hkxs/expansion-delfino/hardware/Delfino_Audio_Cape/Docs/Tarjeta/3D_Front.jpg

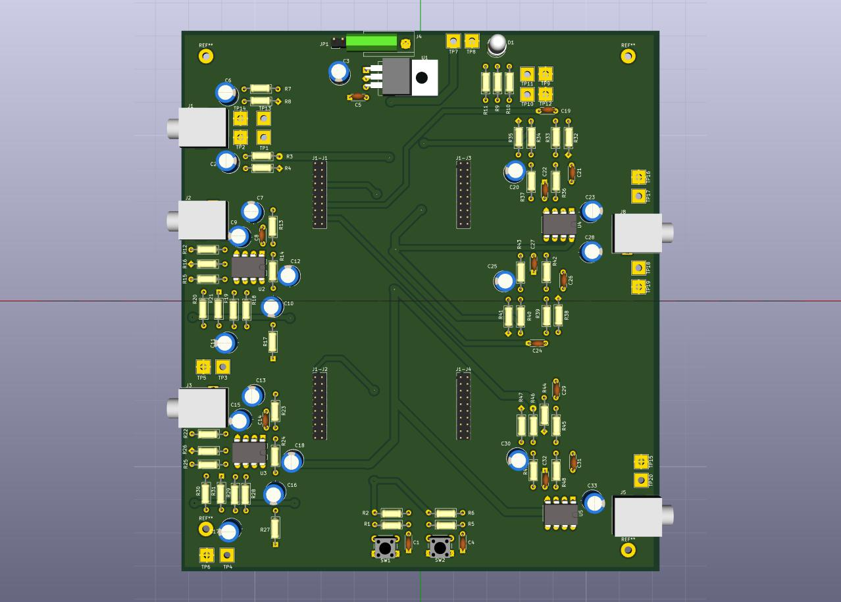
hardware/Delfino_Audio_Cape/Docs/Tarjeta/3D_Front.jpg
