hkxs/expansion-delfino/hardware/Delfino_Audio_Cape/Docs/Tarjeta/3D_Back.jpg

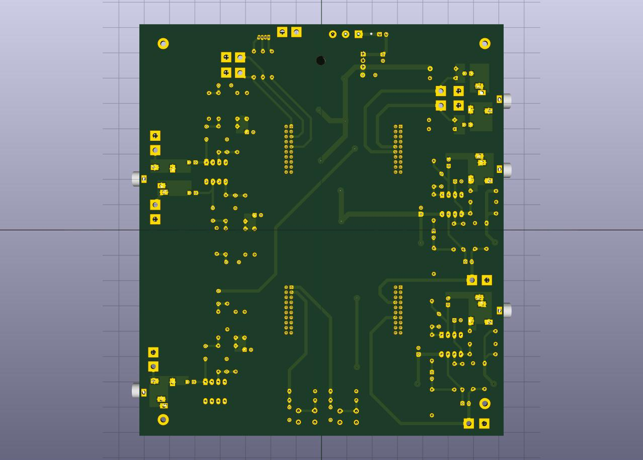
hardware/Delfino_Audio_Cape/Docs/Tarjeta/3D_Back.jpg
