hkxs/expansion-delfino/README.md

# expansion-delfino
Tarjeta de expansión para el launchpad LAUNCHXL-F28377S

Para un tutorial rápido sobre el MCU TMS320F28377S se puede consultar:

http://odin.fi-b.unam.mx/labdsp/files/ADSP/apuntes/Tutorial_VF.pdf
