hkxs/expansion-delfino/hardware/NOTES.md

Todos los proyectos están creados en KiCad.

En caso de fabricación casera, se recomienda usar vías de 100 mil y pistas de al menos 35 mil.
