hkxs/expansion-delfino/hardware/Delfino_Audio_Cape/Docs/Simulacion/LP_Filter/respuesta_freq.bmp

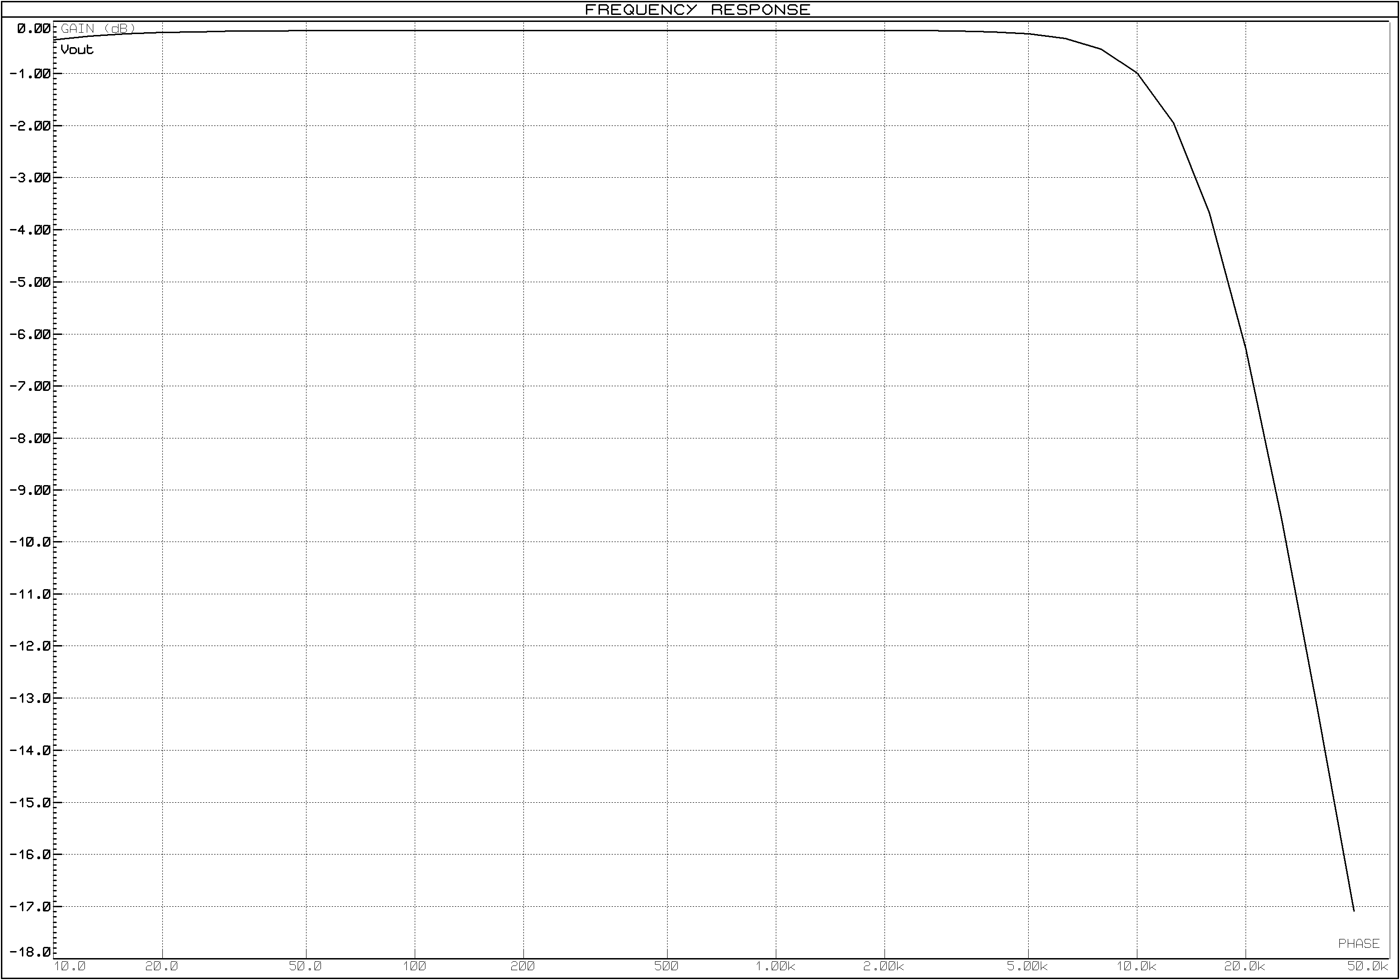
hardware/Delfino_Audio_Cape/Docs/Simulacion/LP_Filter/respuesta_freq.bmp
