hkxs/expansion-delfino/hardware/Amp_Mic/esquematico.pdf

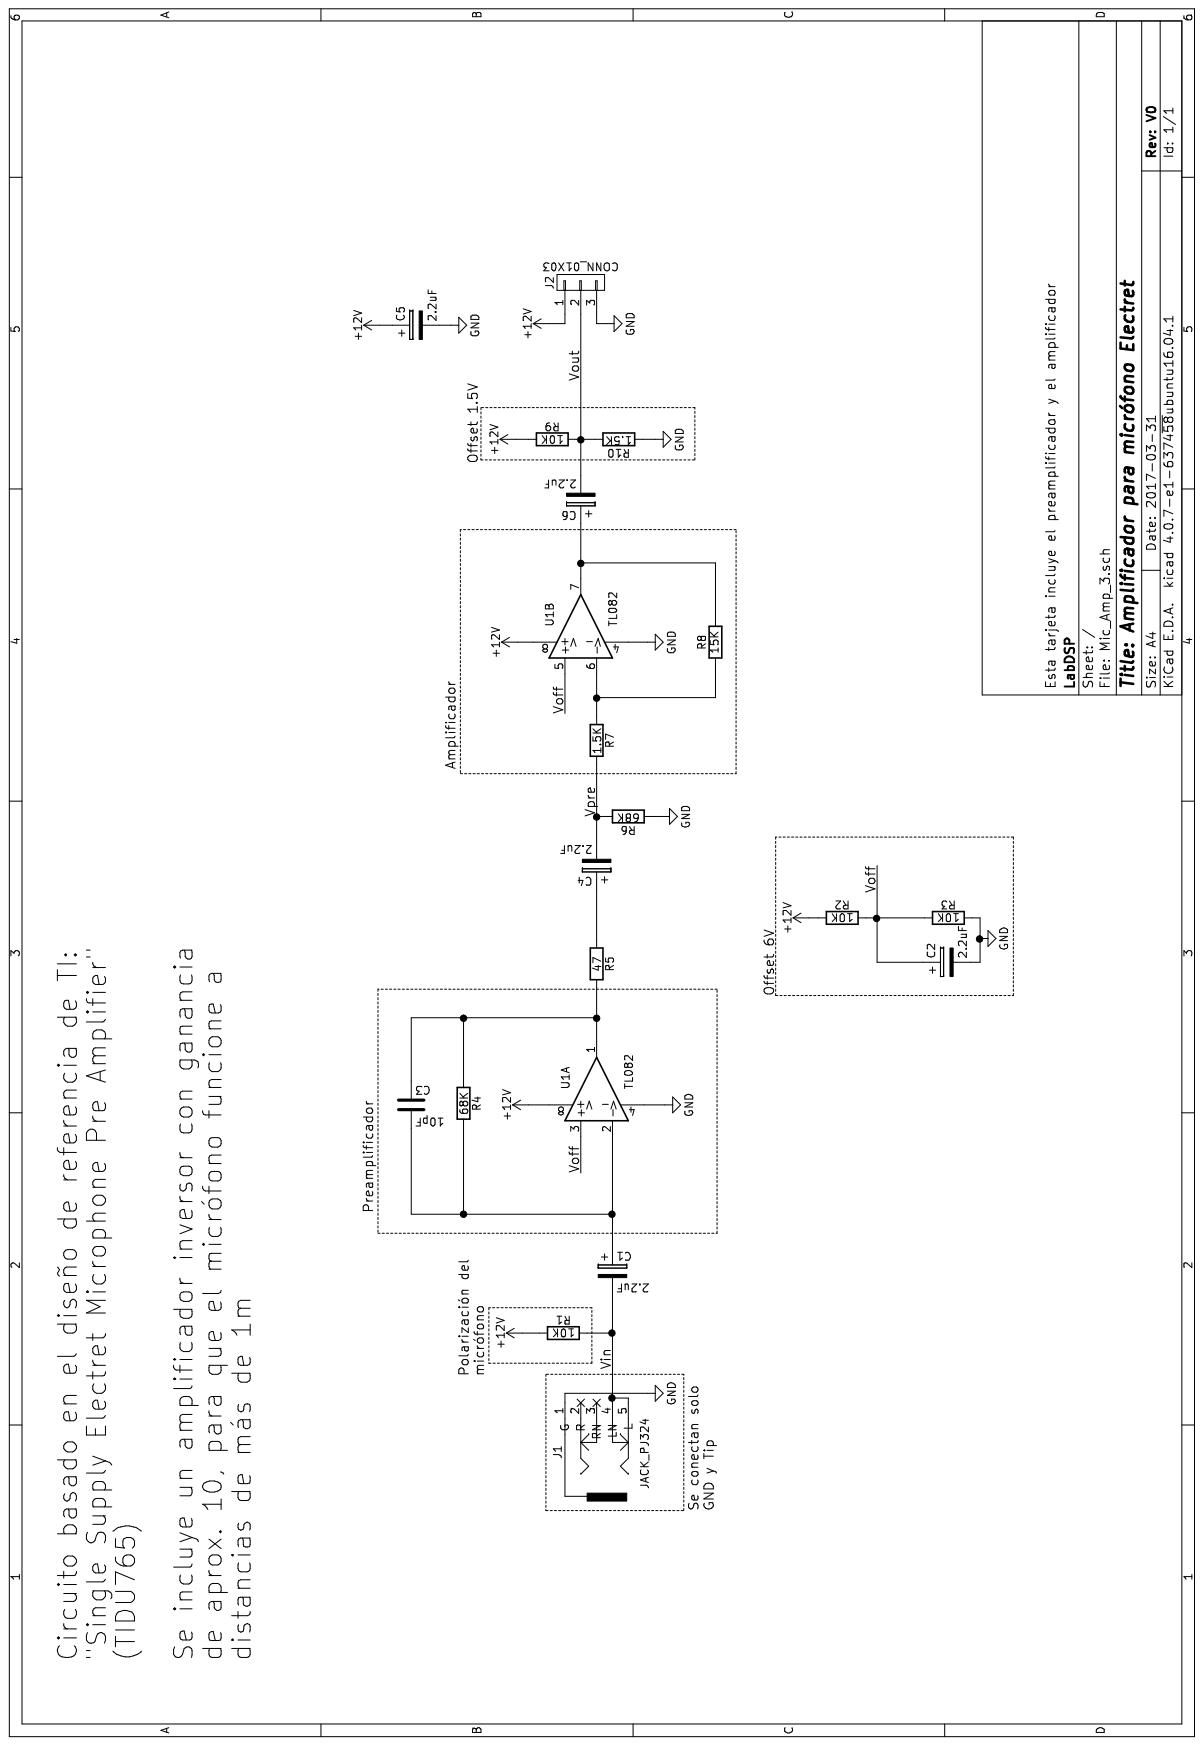
[picture p5: page 1]
