hkxs/expansion-delfino/hardware/Delfino_Audio_Cape/Docs/Tarjeta/expansion.pdf

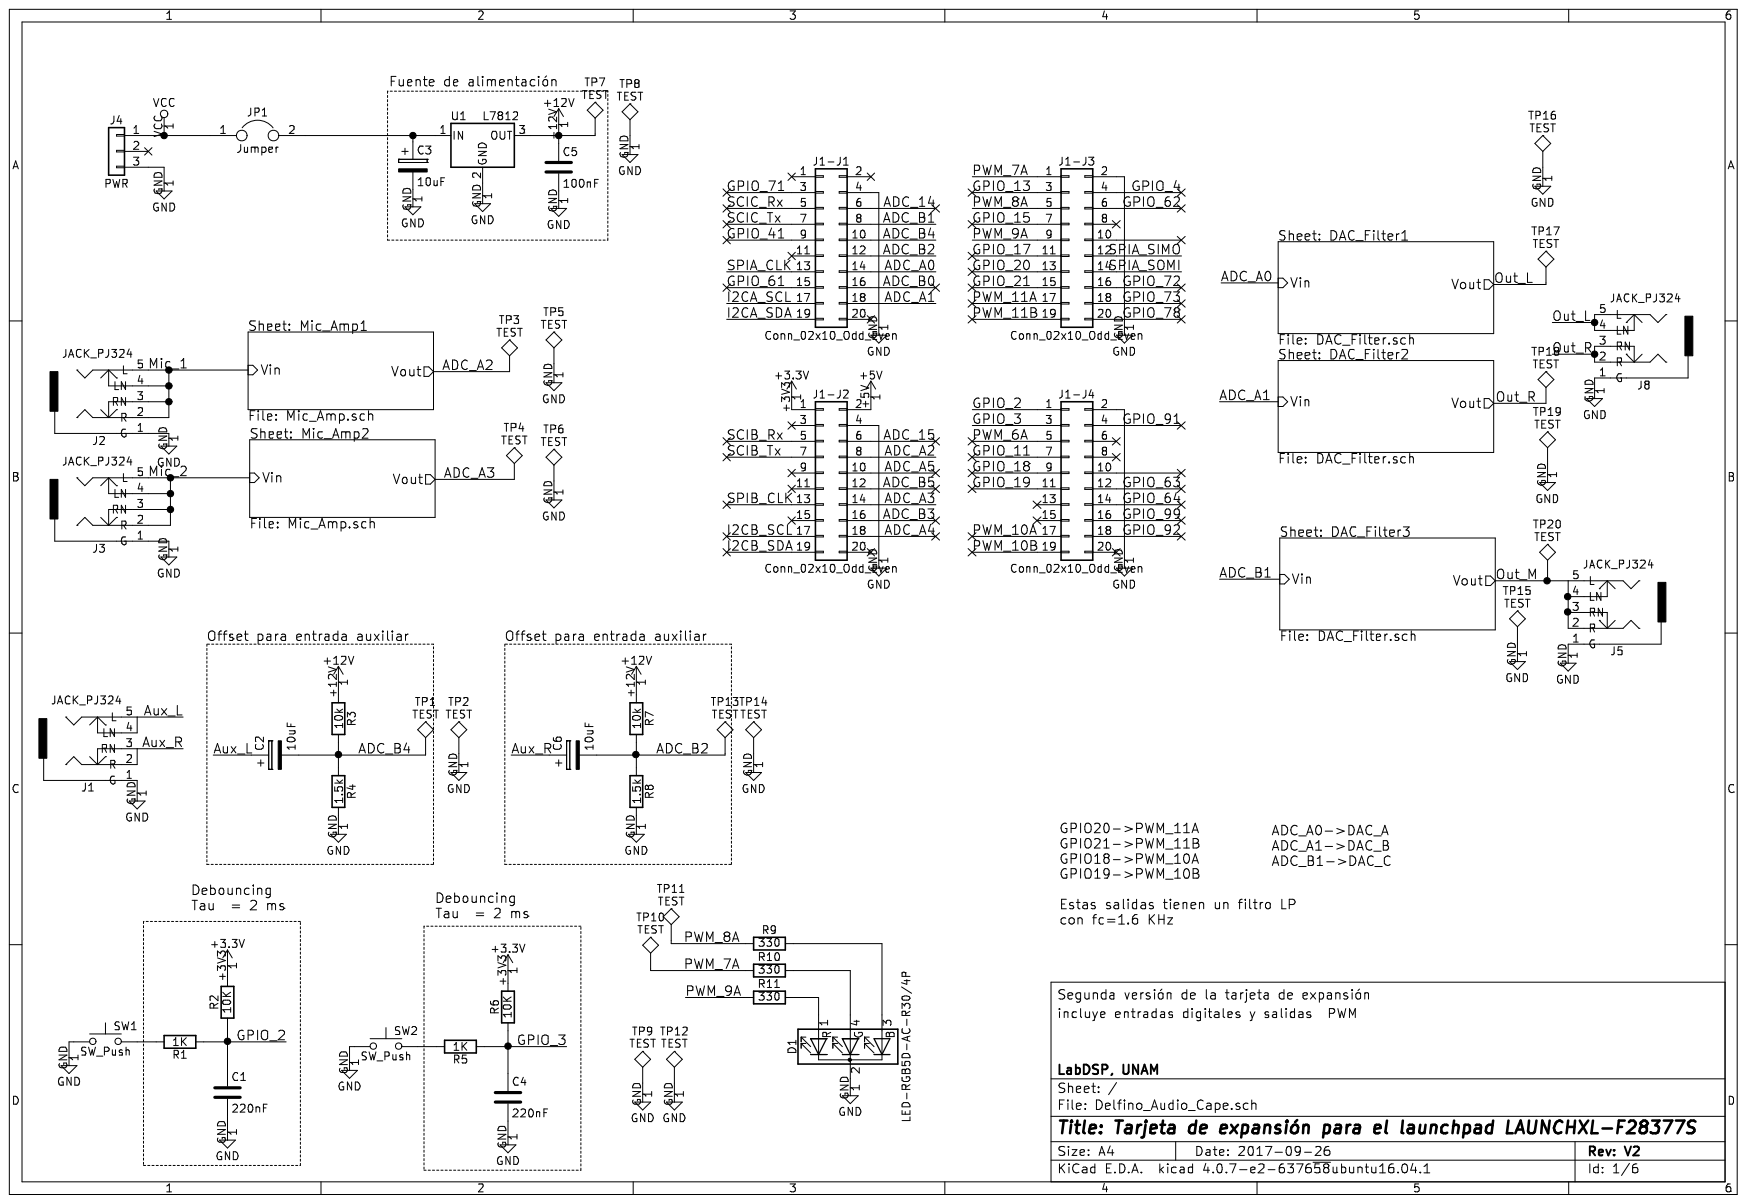
[picture p6: page 1]
