hkxs/expansion-delfino/hardware/Delfino_Audio_Cape/Docs/Tarjeta/LP.pdf

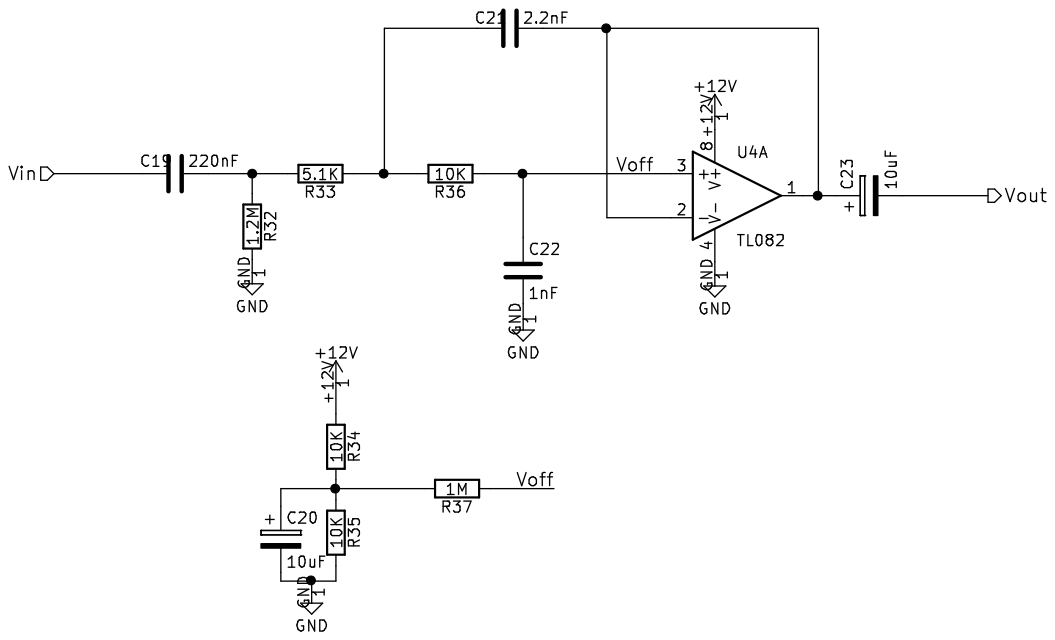
[picture p7: page 1]
