hkxs/expansion-delfino/hardware/Delfino_Audio_Cape/Docs/Tarjeta/preamp.pdf

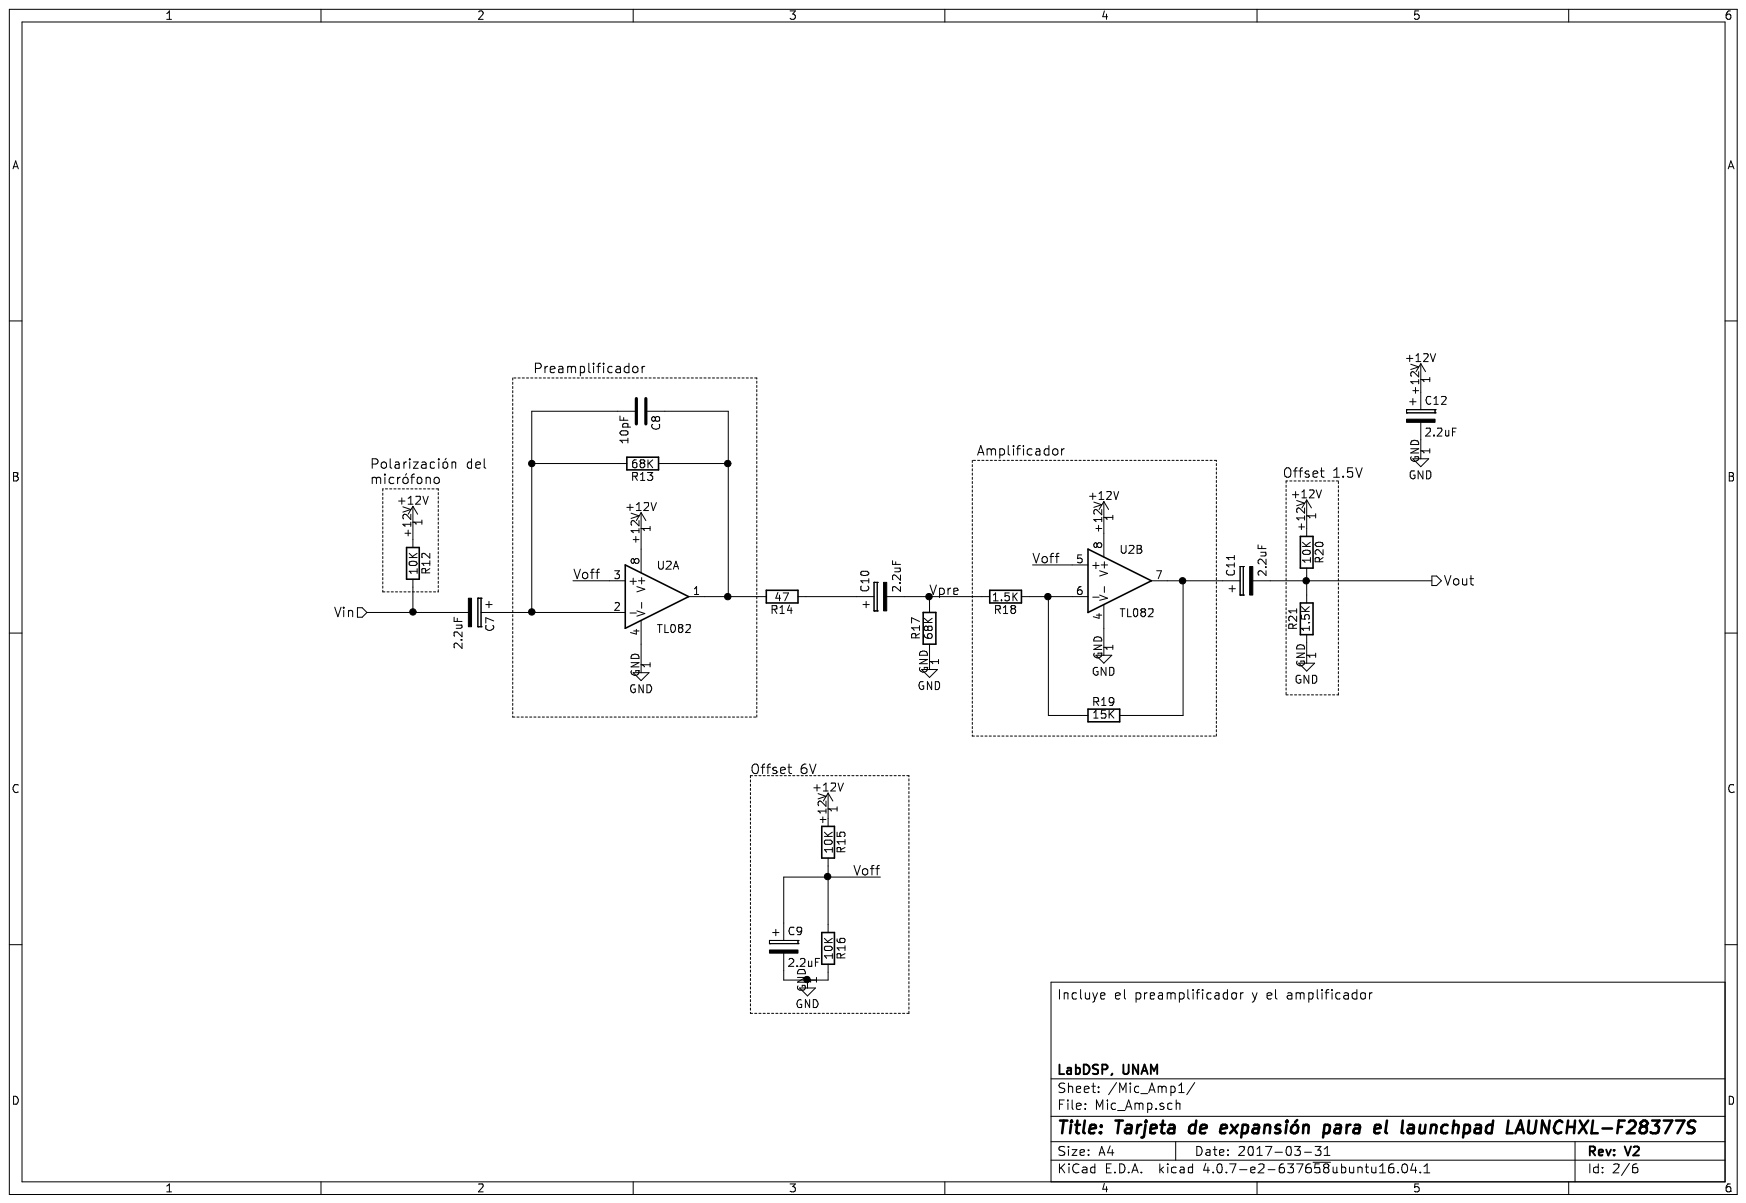
[picture p8: page 1]
