hkxs/expansion-delfino/hardware/Delfino_Audio_Cape/Docs/Tarjeta/PCB.pdf

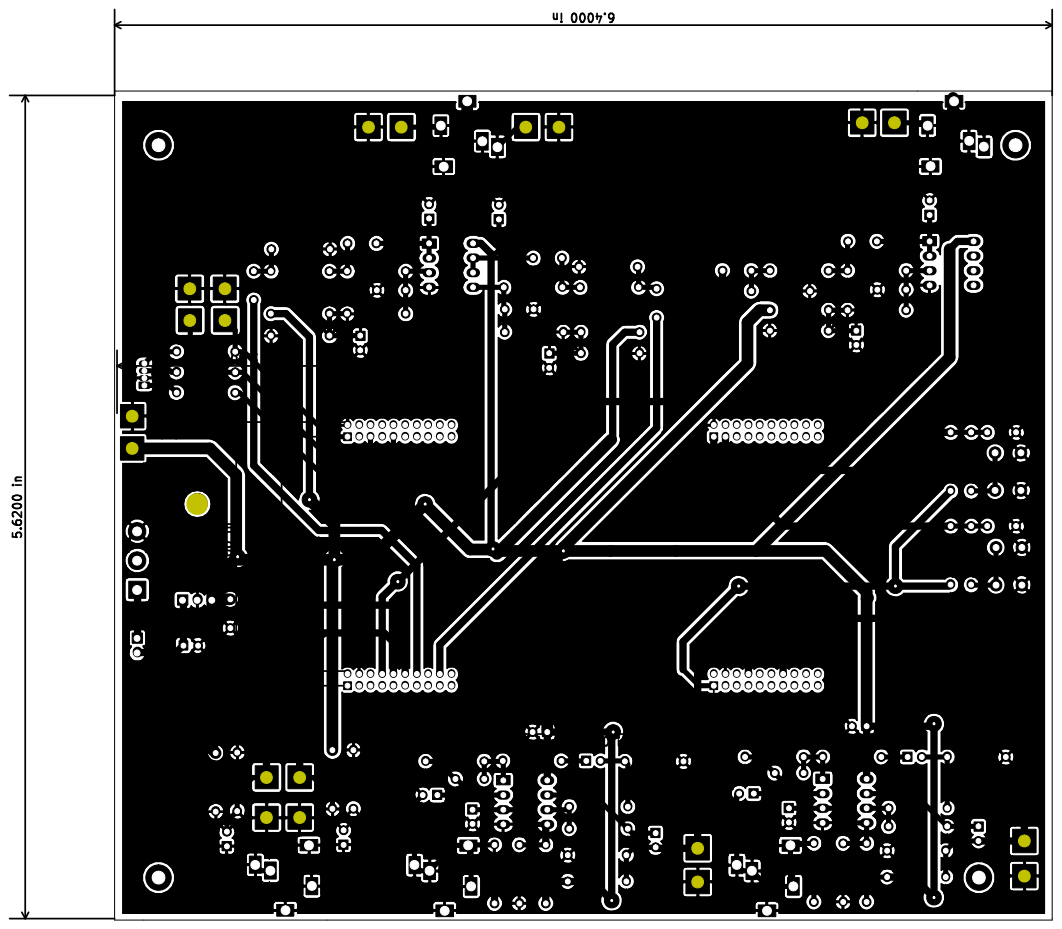
[picture p15: page 1]
