hkxs/expansion-delfino/hardware/Delfino_Audio_Cape/Docs/Simulacion/LP_Filter/LP_Filter.PDF

C2

U1:A

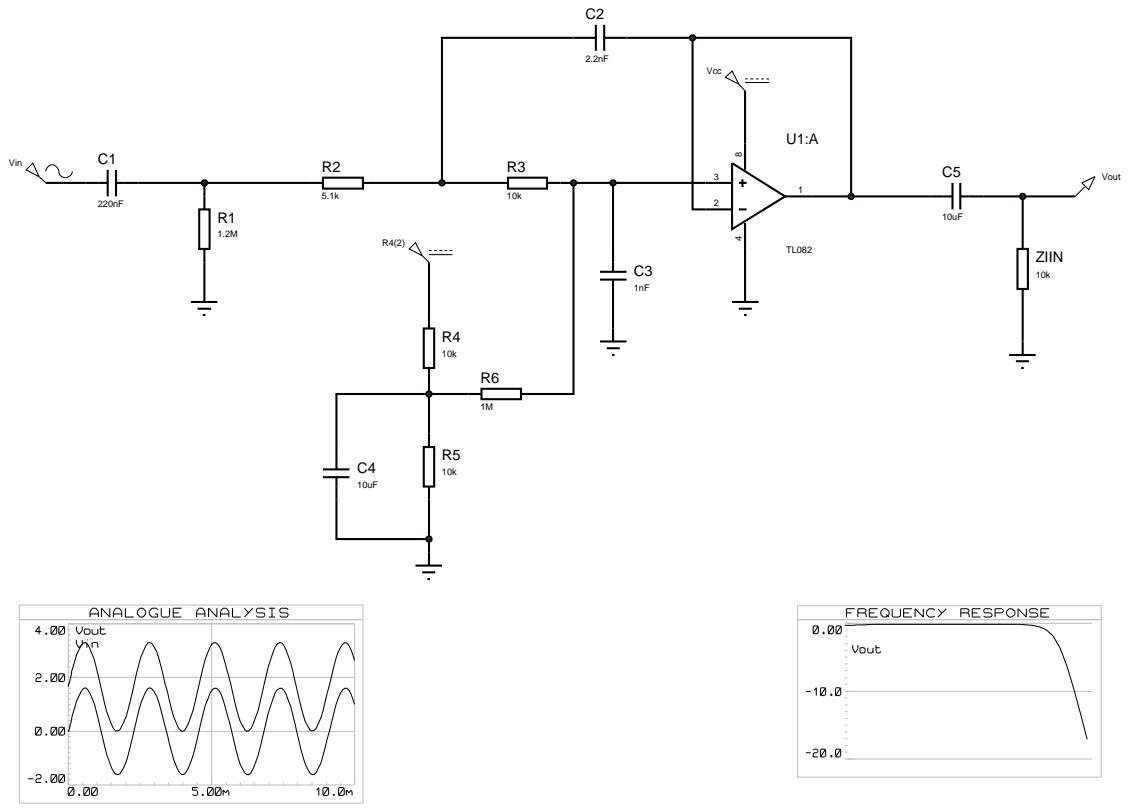
[picture p16: page 1]
