hkxs/expansion-delfino/hardware/Delfino_Audio_Cape/Delfino_Audio_Cape.kicad_pcb

## KiCad design hardware/Delfino_Audio_Cape/Delfino_Audio_Cape.kicad_pcb (2017-11-21)

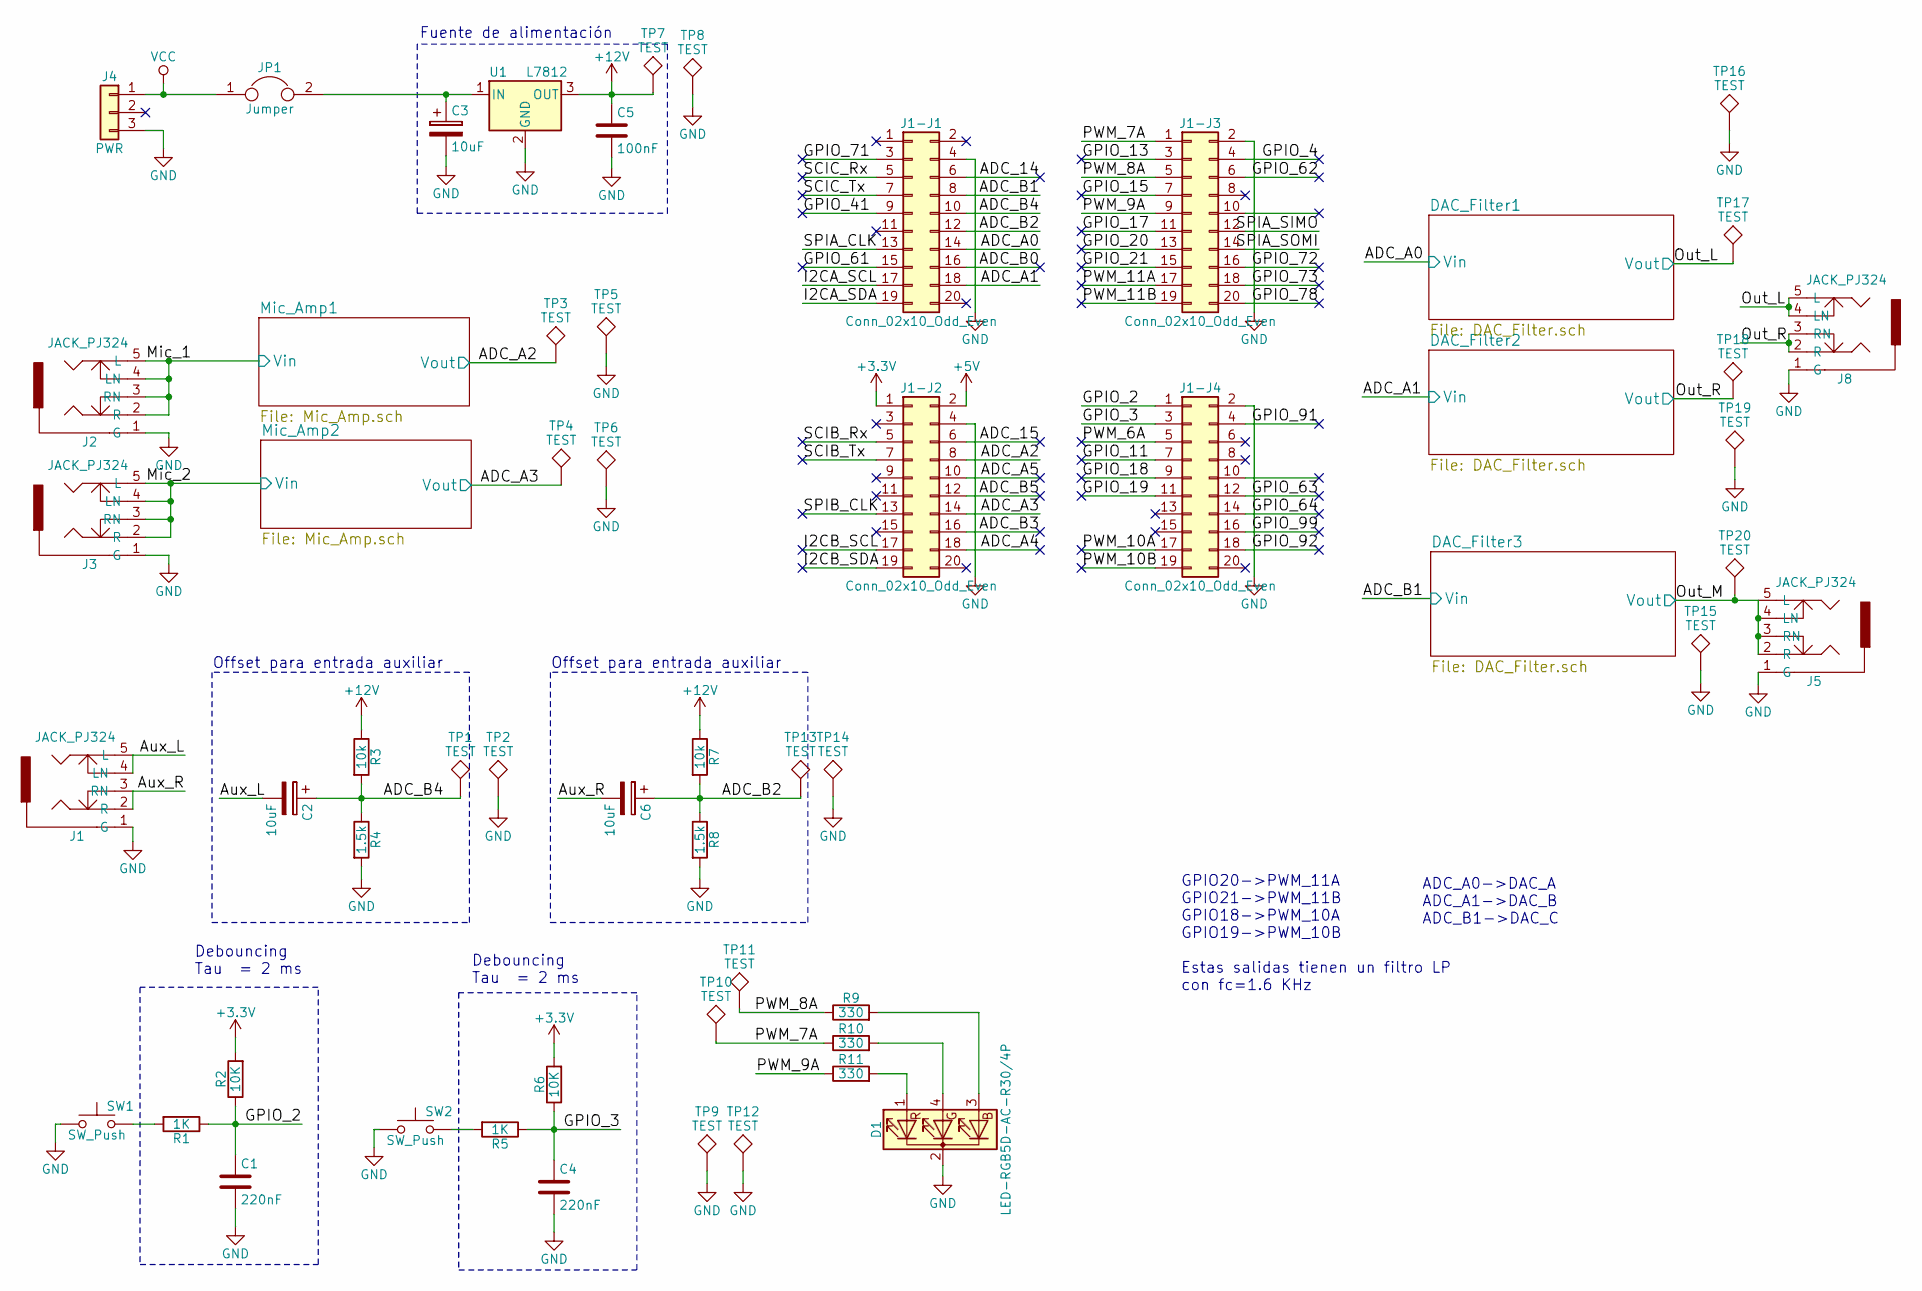
[picture p17: schematic Delfino_Audio_Cape.sch, Tarjeta de expansión para el launchpad LAUNCHXL-F28377S]

Parts:
C1, C4: 220nF; C_Disc_D4.3mm_W1.9mm_P5.00mm
C2, C3, C6: 10uF; CP_Radial_D6.3mm_P2.50mm
C5: 100nF; C_Disc_D4.3mm_W1.9mm_P5.00mm
D1: LED-RGB5D-AC-R30/4P; LED_D5.0mm-4
J1, J2, J3, J5, J8: JACK_PJ324; PJ-324
J1-J1, J1-J2, J1-J3, J1-J4: Conn_02x10_Odd_Even; Pin_Header_Straight_2x10_Pitch2.54mm
J4: PWR; bornier3
JP1: Jumper; Pin_Header_Straight_1x02_Pitch2.54mm
R1, R5: 1K; R_Axial_DIN0207_L6.3mm_D2.5mm_P10.16mm_Horizontal
R2, R6: 10K; R_Axial_DIN0207_L6.3mm_D2.5mm_P10.16mm_Horizontal
R3, R7: 10k; R_Axial_DIN0207_L6.3mm_D2.5mm_P10.16mm_Horizontal
R4, R8: 1.5k; R_Axial_DIN0207_L6.3mm_D2.5mm_P10.16mm_Horizontal
R9, R10, R11: 330; R_Axial_DIN0207_L6.3mm_D2.5mm_P10.16mm_Horizontal
SW1, SW2: SW_Push; SW_PUSH_6mm
TP1, TP2, TP3, TP4, TP5, TP6, TP7, TP8, TP9, TP10, TP11, TP12, TP13, TP14, TP15, TP16, TP17, TP18, TP19, TP20: TEST; Test_Point_THTPad_4.0x4.0mm_Drill2.0mm
U1: L7812; TO-220_Horizontal

Connections:
+3V3: J1-J2.1, R2.2, R6.2
+5V: J1-J2.2
+12V: C5.1, R3.1, R7.1, TP7.1, U1.3 (OUT); also elsewhere on the board
/ADC_14: J1-J1.6
/ADC_15: J1-J2.6
/ADC_A0: J1-J1.14; also elsewhere on the board
/ADC_A1: J1-J1.18; also elsewhere on the board
/ADC_A2: J1-J2.8, TP3.1; also elsewhere on the board
/ADC_A3: J1-J2.14, TP4.1; also elsewhere on the board
/ADC_A4: J1-J2.18
/ADC_A5: J1-J2.10
/ADC_B0: J1-J1.16
/ADC_B1: J1-J1.8; also elsewhere on the board
/ADC_B2: C6.1, J1-J1.12, R7.2, R8.1, TP13.1
/ADC_B3: J1-J2.16
/ADC_B4: C2.1, J1-J1.10, R3.2, R4.1, TP1.1
/ADC_B5: J1-J2.12
/Aux_L: C2.2, J1.4 (LN), J1.5 (L)
/Aux_R: C6.2, J1.2 (R), J1.3 (RN)
/GPIO_2: C1.1, J1-J4.1, R1.1, R2.1
/GPIO_3: C4.1, J1-J4.3, R5.1, R6.1
/GPIO_4: J1-J3.4
/GPIO_11: J1-J4.7
/GPIO_13: J1-J3.3
/GPIO_15: J1-J3.7
/GPIO_17: J1-J3.11
/GPIO_18: J1-J4.9
/GPIO_19: J1-J4.11
/GPIO_20: J1-J3.13
/GPIO_21: J1-J3.15
/GPIO_41: J1-J1.9
/GPIO_61: J1-J1.15
/GPIO_62: J1-J3.6
/GPIO_63: J1-J4.12
/GPIO_64: J1-J4.14
/GPIO_71: J1-J1.3
/GPIO_72: J1-J3.16
/GPIO_73: J1-J3.18
/GPIO_78: J1-J3.20
/GPIO_91: J1-J4.4
/GPIO_92: J1-J4.18
/GPIO_99: J1-J4.16
/I2CA_SCL: J1-J1.17
/I2CA_SDA: J1-J1.19
/I2CB_SCL: J1-J2.17
/I2CB_SDA: J1-J2.19
/Mic_1: J2.2 (R), J2.3 (RN), J2.4 (LN), J2.5 (L); also elsewhere on the board
/Mic_2: J3.2 (R), J3.3 (RN), J3.4 (LN), J3.5 (L); also elsewhere on the board
/Out_L: J8.4 (LN), J8.5 (L), TP17.1; also elsewhere on the board
/Out_M: J5.2 (R), J5.3 (RN), J5.4 (LN), J5.5 (L), TP20.1; also elsewhere on the board
/Out_R: J8.2 (R), J8.3 (RN), TP18.1; also elsewhere on the board
/PWM_6A: J1-J4.5
/PWM_7A: J1-J3.1, R10.1, TP10.1
/PWM_8A: J1-J3.5, R9.1, TP11.1
/PWM_9A: J1-J3.9, R11.1
/PWM_10A: J1-J4.17
/PWM_10B: J1-J4.19
/PWM_11A: J1-J3.17
/PWM_11B: J1-J3.19
/SCIB_Rx: J1-J2.5
/SCIB_Tx: J1-J2.7
/SCIC_Rx: J1-J1.5
/SCIC_Tx: J1-J1.7
/SPIA_CLK: J1-J1.13
/SPIA_SIMO: J1-J3.12
/SPIA_SOMI: J1-J3.14
/SPIB_CLK: J1-J2.13
GND: C1.2, C3.2, C4.2, C5.2, D1.2 (K), J1.1 (G), J1-J1.4, J1-J2.4, J1-J3.2, J1-J4.2, J2.1 (G), J3.1 (G), J4.3, J5.1 (G), J8.1 (G), R4.2, R8.2, SW1.1, SW2.1, TP2.1, TP5.1, TP6.1, TP8.1, TP9.1, TP12.1, TP14.1, TP15.1, TP16.1, TP19.1, U1.2 (GND); also elsewhere on the board
unnamed: C3.1, JP1.2, U1.1 (IN)
unnamed: D1.1 (RA), R11.2
unnamed: D1.3 (BA), R9.2
unnamed: D1.4 (GA), R10.2
unnamed: R1.2, SW1.2
unnamed: R5.2, SW2.2
VCC: J4.1, JP1.1

Notes on the sheet:
ADC_A0->DAC_A ADC_A1->DAC_B ADC_B1->DAC_C
GPIO20->PWM_11A GPIO21->PWM_11B GPIO18->PWM_10A GPIO19->PWM_10B Estas salidas tienen un filtro LP con fc=1.6 KHz
Debouncing Tau = 2 ms
Offset para entrada auxiliar
Fuente de alimentación

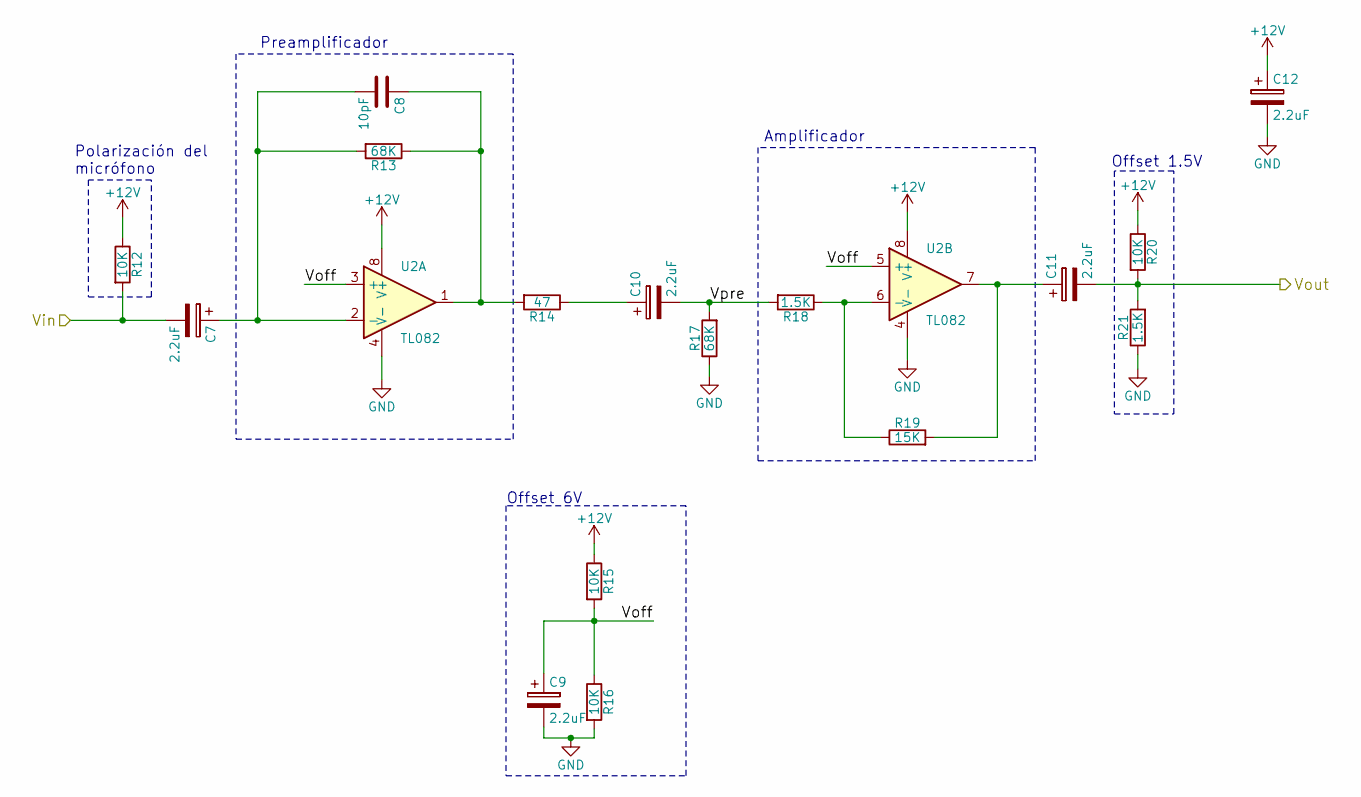
[picture p18: schematic Mic_Amp.sch, Tarjeta de expansión para el launchpad LAUNCHXL-F28377S]

Parts:
C7, C9, C10, C11, C12: 2.2uF; CP_Radial_D6.3mm_P2.50mm
C8: 10pF; C_Disc_D4.3mm_W1.9mm_P5.00mm
R12, R15, R16, R20: 10K; R_Axial_DIN0207_L6.3mm_D2.5mm_P10.16mm_Horizontal
R13, R17: 68K; R_Axial_DIN0207_L6.3mm_D2.5mm_P10.16mm_Horizontal
R14: 47; R_Axial_DIN0207_L6.3mm_D2.5mm_P10.16mm_Horizontal
R18, R21: 1.5K; R_Axial_DIN0207_L6.3mm_D2.5mm_P10.16mm_Horizontal
R19: 15K; R_Axial_DIN0207_L6.3mm_D2.5mm_P10.16mm_Horizontal
U2: TL082; DIP-8_W7.62mm_LongPads

Connections:
+12V: C12.1, R12.1, R15.1, R20.1, U2.8 (V+); also elsewhere on the board
/ADC_A2: C11.2, R20.2, R21.2; also elsewhere on the board
/Mic_1: C7.2, R12.2; also elsewhere on the board
/Mic_Amp1/Voff: C9.1, R15.2, R16.1, U2.3 (+), U2.5 (+)
/Mic_Amp1/Vpre: C10.2, R17.2, R18.2
GND: C9.2, C12.2, R16.2, R17.1, R21.1, U2.4 (V-); also elsewhere on the board
unnamed: C7.1, C8.2, R13.2, U2.2 (-)
unnamed: C8.1, R13.1, R14.2, U2.1
unnamed: C10.1, R14.1
unnamed: C11.1, R19.2, U2.7
unnamed: R18.1, R19.1, U2.6 (-)

Parts of its further copies:
C13, C15, C16, C17, C18: 2.2uF; CP_Radial_D6.3mm_P2.50mm
C14: 10pF; C_Disc_D4.3mm_W1.9mm_P5.00mm
R22, R25, R26, R30: 10K; R_Axial_DIN0207_L6.3mm_D2.5mm_P10.16mm_Horizontal
R23, R27: 68K; R_Axial_DIN0207_L6.3mm_D2.5mm_P10.16mm_Horizontal
R24: 47; R_Axial_DIN0207_L6.3mm_D2.5mm_P10.16mm_Horizontal
R28, R31: 1.5K; R_Axial_DIN0207_L6.3mm_D2.5mm_P10.16mm_Horizontal
R29: 15K; R_Axial_DIN0207_L6.3mm_D2.5mm_P10.16mm_Horizontal
U3: TL082; DIP-8_W7.62mm_LongPads

Connections of its further copies:
+12V: C18.1, R22.1, R25.1, R30.1, U3.8 (V+); also elsewhere on the board
/ADC_A3: C17.2, R30.2, R31.2; also elsewhere on the board
/Mic_2: C13.2, R22.2; also elsewhere on the board
/Mic_Amp2/Voff: C15.1, R25.2, R26.1, U3.3 (+), U3.5 (+)
/Mic_Amp2/Vpre: C16.2, R27.2, R28.2
GND: C15.2, C18.2, R26.2, R27.1, R31.1, U3.4 (V-); also elsewhere on the board
unnamed: C13.1, C14.2, R23.2, U3.2 (-)
unnamed: C14.1, R23.1, R24.2, U3.1
unnamed: C16.1, R24.1
unnamed: C17.1, R29.2, U3.7
unnamed: R28.1, R29.1, U3.6 (-)

Notes on the sheet:
Offset 6V
Polarización del micrófono
Offset 1.5V
Preamplificador
Amplificador

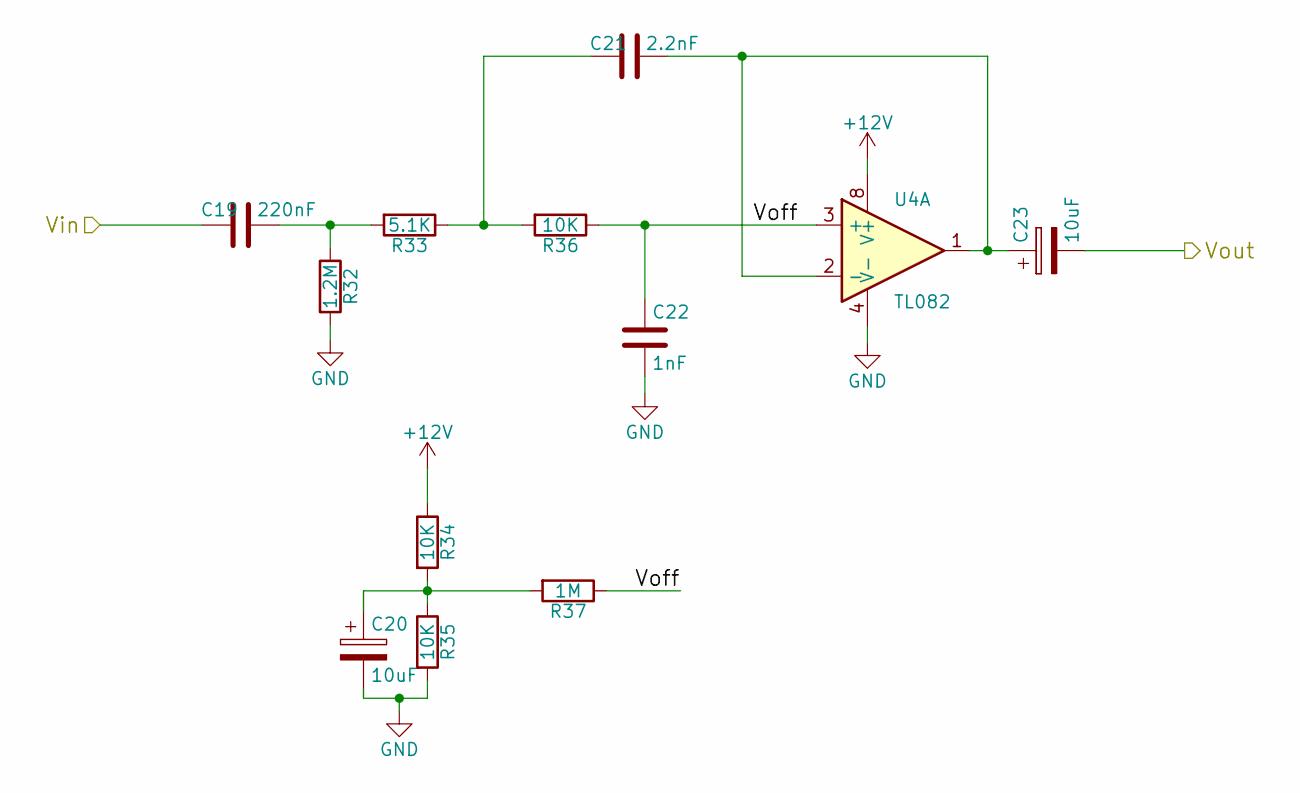
[picture p19: schematic DAC_Filter.sch, Tarjeta de expansión para el launchpad LAUNCHXL-F28377S]

Parts:
C19: 220nF; C_Disc_D4.3mm_W1.9mm_P5.00mm
C20, C23: 10uF; CP_Radial_D6.3mm_P2.50mm
C21: 2.2nF; C_Disc_D4.3mm_W1.9mm_P5.00mm
C22: 1nF; C_Disc_D4.3mm_W1.9mm_P5.00mm
R32: 1.2M; R_Axial_DIN0207_L6.3mm_D2.5mm_P10.16mm_Horizontal
R33: 5.1K; R_Axial_DIN0207_L6.3mm_D2.5mm_P10.16mm_Horizontal
R34, R35, R36: 10K; R_Axial_DIN0207_L6.3mm_D2.5mm_P10.16mm_Horizontal
R37: 1M; R_Axial_DIN0207_L6.3mm_D2.5mm_P10.16mm_Horizontal
U4: TL082; DIP-8_W7.62mm_LongPads

Connections:
+12V: R34.1, U4.8 (V+); also elsewhere on the board
/ADC_A0: C19.2; also elsewhere on the board
/DAC_Filter1/Voff: C22.1, R36.1, R37.1, U4.3 (+)
/DAC_Filter2/Voff: U4.5 (+); also elsewhere on the board
/Out_L: C23.2; also elsewhere on the board
GND: C20.2, C22.2, R32.2, R35.2, U4.4 (V-); also elsewhere on the board
unnamed: C19.1, R32.1, R33.2
unnamed: C20.1, R34.2, R35.1, R37.2
unnamed: C21.1, C23.1, U4.1, U4.2 (-)
unnamed: C21.2, R33.1, R36.2
unnamed 90: U4.6 (-), U4.7; also elsewhere on the board

Parts of its further copies:
C24, C29: 220nF; C_Disc_D4.3mm_W1.9mm_P5.00mm
C25, C28, C30, C33: 10uF; CP_Radial_D6.3mm_P2.50mm
C26, C31: 2.2nF; C_Disc_D4.3mm_W1.9mm_P5.00mm
C27, C32: 1nF; C_Disc_D4.3mm_W1.9mm_P5.00mm
R38, R44: 1.2M; R_Axial_DIN0207_L6.3mm_D2.5mm_P10.16mm_Horizontal
R39, R45: 5.1K; R_Axial_DIN0207_L6.3mm_D2.5mm_P10.16mm_Horizontal
R40, R41, R42, R46, R47, R48: 10K; R_Axial_DIN0207_L6.3mm_D2.5mm_P10.16mm_Horizontal
R43, R49: 1M; R_Axial_DIN0207_L6.3mm_D2.5mm_P10.16mm_Horizontal
U5: TL082; DIP-8_W7.62mm_LongPads

Connections of its further copies:
+12V: R40.1, R46.1, U5.8 (V+); also elsewhere on the board
/ADC_A1: C24.2; also elsewhere on the board
/ADC_B1: C29.2; also elsewhere on the board
/DAC_Filter2/Voff: C27.1, R42.1, R43.1; also elsewhere on the board
/DAC_Filter3/Voff: C32.1, R48.1, R49.1, U5.3 (+)
/Out_M: C33.2; also elsewhere on the board
/Out_R: C28.2; also elsewhere on the board
GND: C25.2, C27.2, C30.2, C32.2, R38.2, R41.2, R44.2, R47.2, U5.4 (V-); also elsewhere on the board
unnamed: C24.1, R38.1, R39.2
unnamed: C25.1, R40.2, R41.1, R43.2
unnamed 90: C26.1, C28.1; also elsewhere on the board
unnamed: C26.2, R39.1, R42.2
unnamed: C29.1, R44.1, R45.2
unnamed: C30.1, R46.2, R47.1, R49.2
unnamed: C31.1, C33.1, U5.1, U5.2 (-)
unnamed: C31.2, R45.1, R48.2

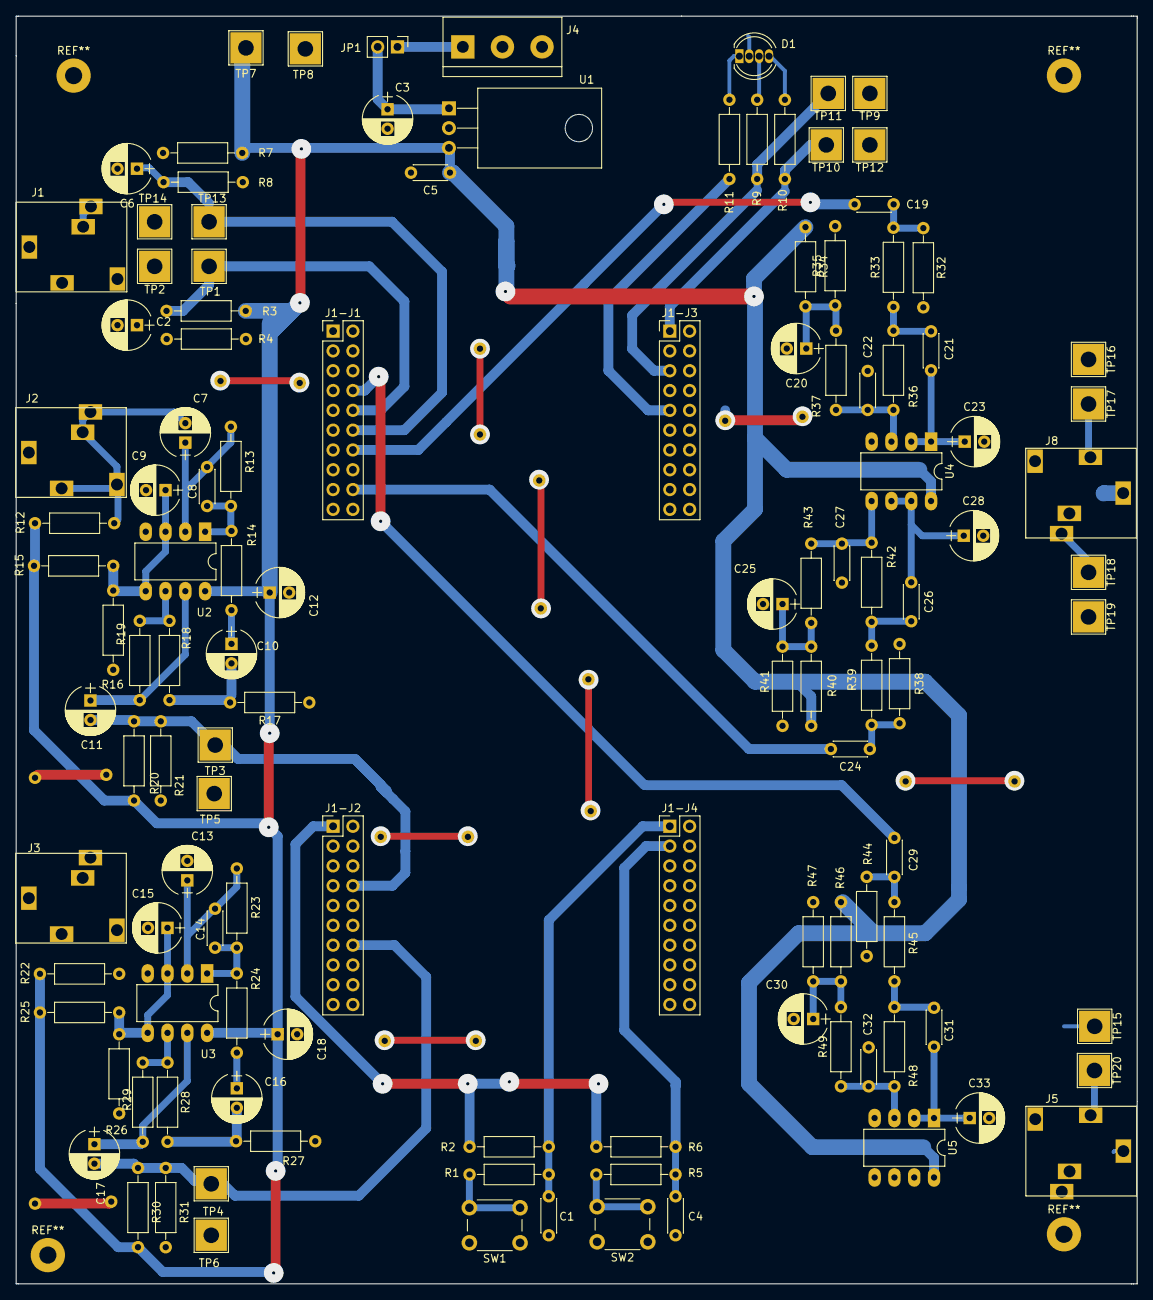
[picture p20: board Delfino_Audio_Cape.kicad_pcb from above]

Board: 2 copper layers, 143.8 x 162.6 mm, 121 parts (0 on the bottom side), 58 nets.
