hkxs/expansion-delfino/hardware/Amp_Mic/Mic_Amp_3.kicad_pcb

## KiCad design hardware/Amp_Mic/Mic_Amp_3.kicad_pcb (2017-08-17)

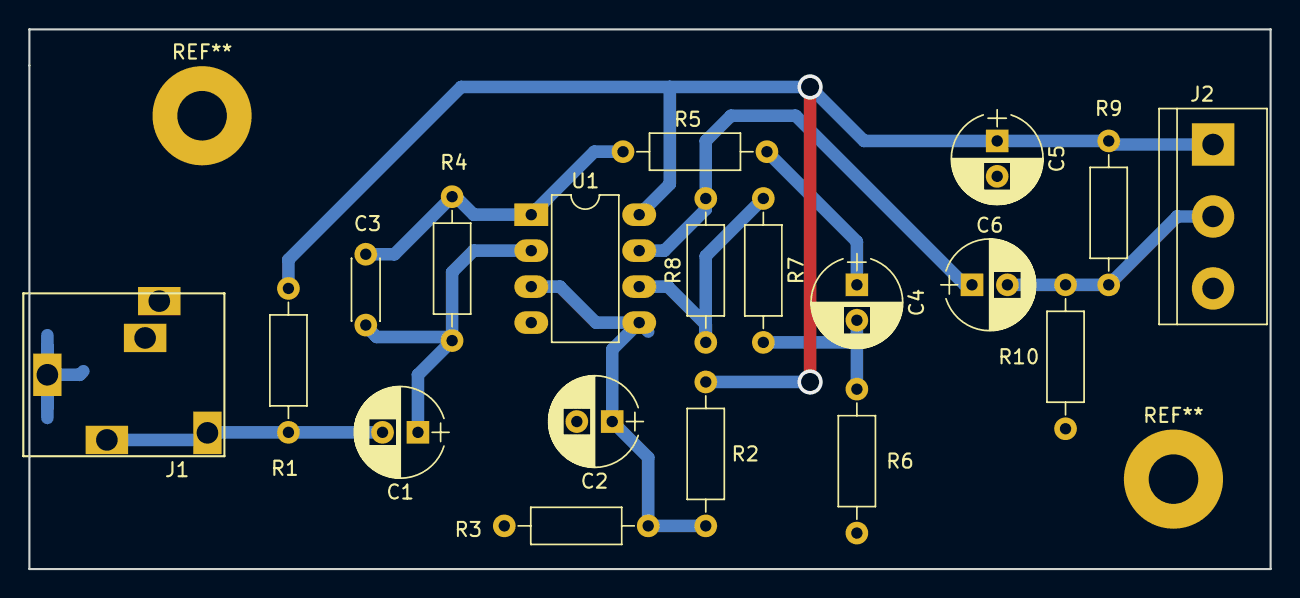
[picture p21: board Mic_Amp_3.kicad_pcb from above]

Board: 2 copper layers, 87.6 x 38.1 mm, 19 parts (0 on the bottom side), 11 nets.

Parts:
C1, C2, C4, C5, C6: 2.2uF; CP_Radial_D6.3mm_P2.50mm
C3: 10pF; C_Disc_D4.3mm_W1.9mm_P5.00mm
J1: JACK_PJ324; PJ-324
J2: CONN_01X03; bornier3
R1, R2, R3, R9: 10K; R_Axial_DIN0207_L6.3mm_D2.5mm_P10.16mm_Horizontal
R4, R6: 68K; R_Axial_DIN0207_L6.3mm_D2.5mm_P10.16mm_Horizontal
R5: 47; R_Axial_DIN0207_L6.3mm_D2.5mm_P10.16mm_Horizontal
R7, R8, R10: 1.5K; R_Axial_DIN0207_L6.3mm_D2.5mm_P10.16mm_Horizontal
U1: TL082; DIP-8_W7.62mm_LongPads

Connections:
+12V: C5.1, J2.1, R1.1, R2.1, R9.1, U1.8
/Vin: C1.2, J1.4, J1.5, R1.2
/Voff: C2.1, R2.2, R3.1, U1.3, U1.5
/Vout: C6.2, J2.2, R9.2, R10.2
/Vpre: C4.2, R6.2, R7.2
GND: C2.2, C5.2, J1.1, J2.3, R3.2, R6.1, R10.1, U1.4
unnamed: C1.1, C3.2, R4.2, U1.2
unnamed: C3.1, R4.1, R5.2, U1.1
unnamed: C4.1, R5.1
unnamed: C6.1, R8.2, U1.7
unnamed: R7.1, R8.1, U1.6
