hkxs/expansion-delfino/(commit log)

2017-08-16 CMD genérico para ejecutar programas desde RAM
2017-08-16 Libreria para manejo del sistema analógico
2017-08-16 Libreria para usar el puerto UART
2017-08-17 Ejemplo de uso del subsistema analógico
2017-08-17 Ejemplo de uso de la FFT
2017-08-17 Ejemplo de uso del PWM en esamblador
2017-08-17 Ejemplo para la tarjeta de evaluación del laboratorio
2017-08-17 Ejemplo de uso de timer en ensamblador
2017-08-17 Ejemplo de uso de timer
2017-08-17 Ejemplo de uso del puerto serial
2017-08-17 CMD genérico para ejecutar programas desde FLASH
2017-08-17 Ejemplo uso de GPIO
2017-08-17 Ejemplo uso de GPIO en ensamblador
2017-08-17 Amplificador para micrófono electret
    [Mic_Amp_3.kicad_pcb, Mic_Amp_3.sch]
2017-08-17 Notas para fabricación
2017-08-17 Filtro paso bajas a 20KHz para el DAC
    [Filter_LP.kicad_pcb, Filter_LP.sch]
2017-08-29 Proyecto y simulaciones del filtro para el DAC
2017-09-06 Ejemplo de configuración del puerto SPI
2017-09-14 Boosterpack de audio para la Delfino
    [DAC_Filter.sch, Delfino_Audio_Cape.kicad_pcb, Delfino_Audio_Cape.sch, Mic_Amp.sch]
2017-09-21 Avances de la tarjeta de expansión
    [DAC_Filter.sch, Delfino_Audio_Cape.kicad_pcb, Delfino_Audio_Cape.sch, Mic_Amp.sch]
2017-09-25 Avances en tarjeta de expansión
    [Delfino_Audio_Cape.kicad_pcb]
2017-09-26 Avances en el PCB
    [DAC_Filter.sch, Delfino_Audio_Cape.kicad_pcb, Delfino_Audio_Cape.sch, Mic_Amp.sch]
2017-09-26 Se genero parte de la documentación de la tarjeta
    [DAC_Filter.sch, Delfino_Audio_Cape.kicad_pcb, Delfino_Audio_Cape.sch, Mic_Amp.sch]
2017-10-09 Cambios en el PCB
    [Delfino_Audio_Cape.kicad_pcb]
2017-10-26 Cambios en el PCB de la tarjeta de expansión
    [DAC_Filter.sch, Delfino_Audio_Cape.kicad_pcb, Delfino_Audio_Cape.sch]
